eliftplgl/EE464-Hardware-Project-FlyBusri/WhatsApp Görsel 2024-06-12 saat 21.42.05_42f40c0c.jpg

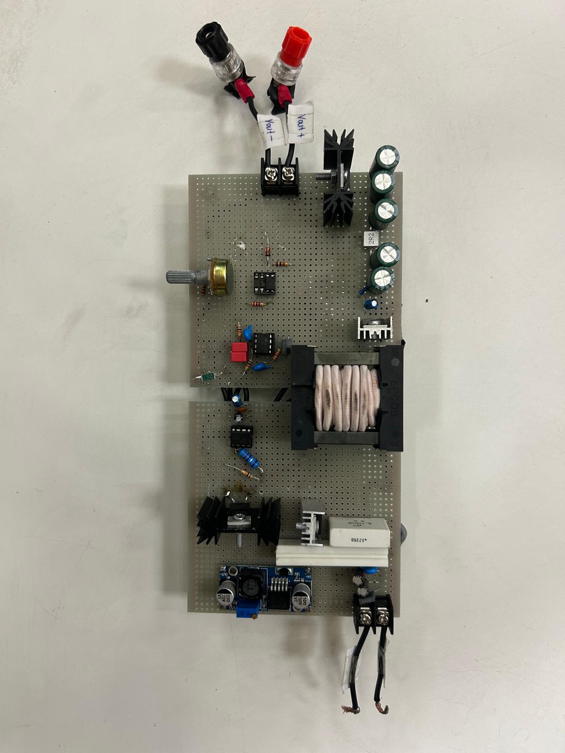
WhatsApp Görsel 2024-06-12 saat 21.42.05_42f40c0c.jpg
