eliftplgl/EE464-Hardware-Project-FlyBusri/README.md

# EE 464-Hardware-Project
EE464 Hardware Project

Elif Topaloğlu - 2443984

Caner Aydın - 2374528

Doruk Yazıcı - 2517225
