eliftplgl/EE464-Hardware-Project-FlyBusri/flyback_closed_uc3845.asc

C1: cap; 317n; V=100 Irms=3.41 Rser=0.0261749 Lser=0
C2: cap; 470p
C3: cap; 100n
C4: cap; 1n
C5: polcap; 660µ; V=35 Irms=2.78 Rser=0.0173 Lser=7.212n
C6: cap; 470p
C7: cap; 1n
C8: cap; 1µ; V=100 Irms=2.96 Rser=0.029149 Lser=0
C9: polcap; 1000µ; V=35 Irms=1.06 Rser=0.0442 Lser=7.087n
C10: cap; 4.7µ
C13: cap; 1µ; V=100 Irms=2.96 Rser=0.029149 Lser=0
D1: schottky; RBQ30NS100A
D2: schottky; RBQ30NS100A
D3: zener; TDZ10B
L1: ind; 0.215µ
L2: ind; 2.2µ
L3: ind2; 24.25µ
L4: ind2; 24.25µ
L5: ind; 0.215µ
M2: nmos; IRFR2607Z
R1: res; 408
R2: res; 10k
R3: res; 2.2k
R4: res; 8.87
R5: res; 1k
R6: res; 10.7k
R7: res; 2.4
R8: res; 2.7k
R9: res; 2.7k
R10: res; 2.2k
R11: res; 2.8k
R12: res; 2.7k
R17: res; 300
R18: res; 50m
R19: res; 10k
U2: PC817A
V1: voltage; 15
Vin: voltage; 40
X1: UC3845
Named nets: Isense, Reference, Output, 0, Feedback, Vout, Vcc
.tran 1
K L3 L4 1
FlyBusri 20-40V Closed-Loop Flyback Converter Simulation
