eliftplgl/EE464-Hardware-Project-FlyBusri/sim_openloop.asc

C1: cap; 100µ
C2: cap; 317n
D1: schottky; RB298NS100
D2: schottky; RB238NS150
L2: ind2; 24.25µ; Rser=4.5m Rpar=33
L3: ind2; 24.25µ
L4: ind; 0.215µ
L5: ind; 0.215µ
M1: nmos; IRFR2607Z
R1: res; 2.4
R3: res; 408
V1: voltage; 20
V2: voltage; PULSE(0 10 0 1n 1n 5u 12.5u)
Named nets: 0
K L2 L3 1
.tran 3m
